siliconvalley4066/RaspberryPiPicoWTFTOscilloscope/README.md

# RaspberryPiPicoWTFTOscilloscope
Raspberry Pi Pico W Oscilloscope for 320x240 TFT LCD and wireless WEB display

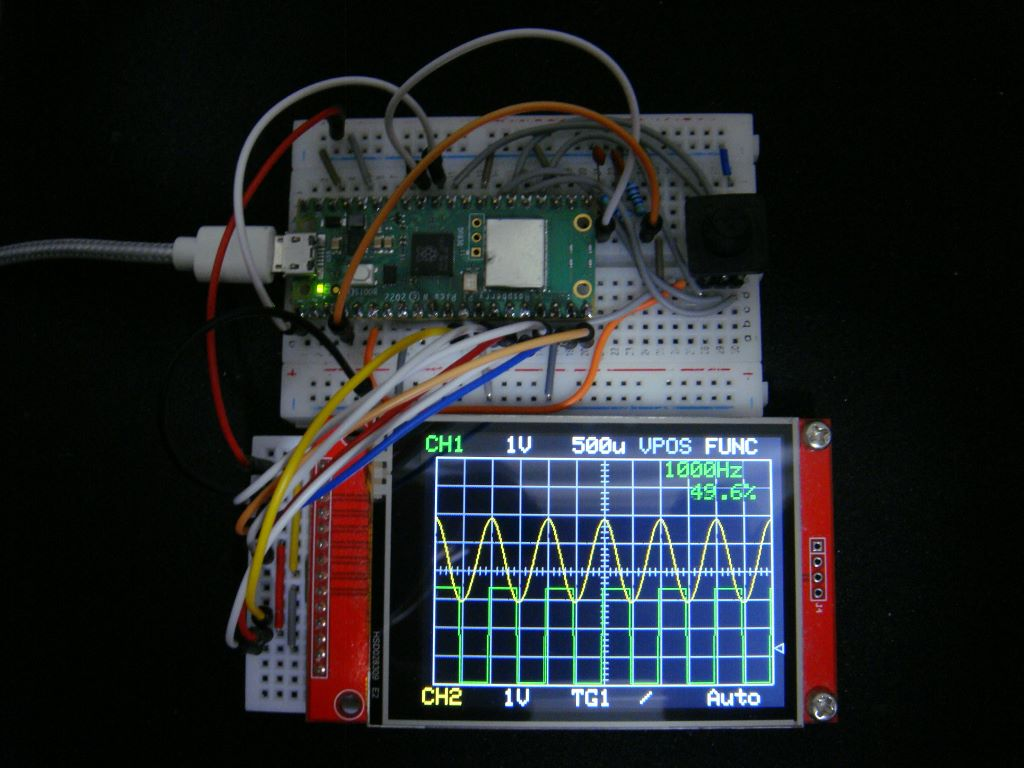
[picture p1: DSC03477.jpg]

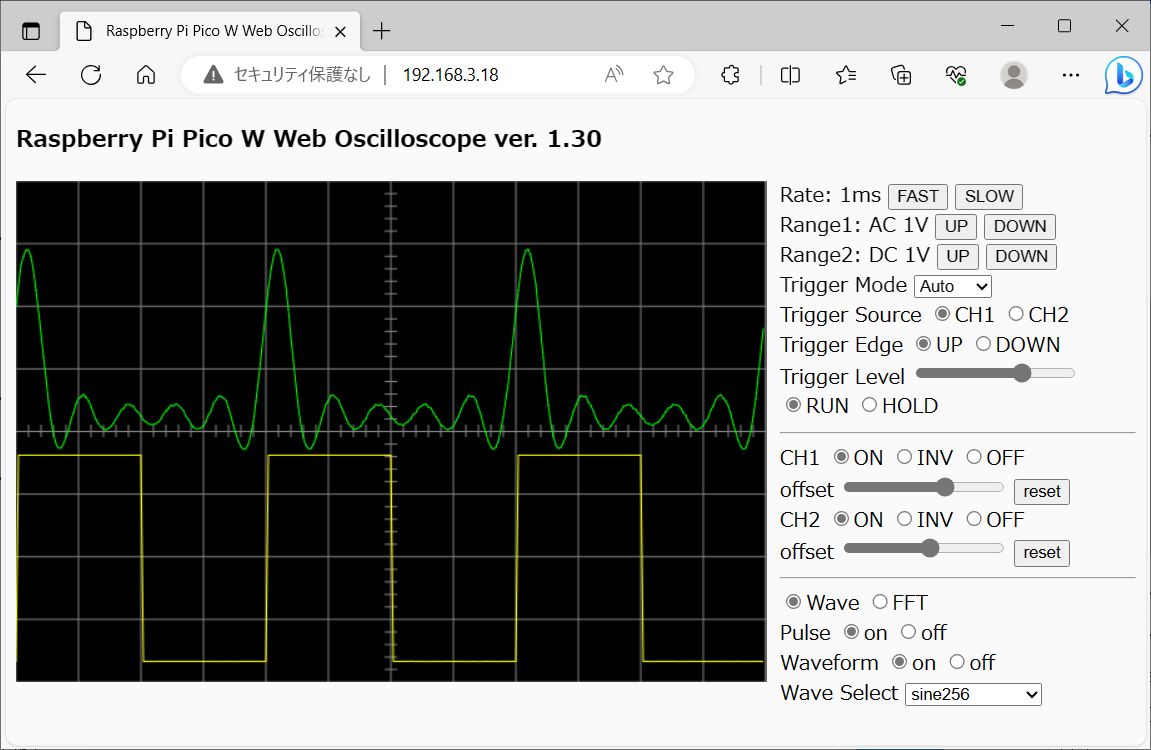
[picture p2: RPPicoWEBTFT.png]


This displays an oscilloscope screen on a 320x240 TFT LCD and also on the WEB page simultaneusly.
The settings are controled on the touch screen of the TFT LCD and by the 5 direction switch and also on the WEB page.
You can view the oscilloscope screen on the WEB browser of the PC or the tablet or the smartphone.
It contains Pulse Generator, DDS Function Generator and Frequency Counter.

Specifications:
<li>Dual input channel</li>
<li>Input voltage range 0 to 3.3V</li>
<li>12 bit ADC 2 Msps single channel, 250 ksps dual channel</li>
<li>Measures minimum, maximum and average values</li>
<li>Measures frequency and duty cycle</li>
<li>Spectrum FFT analysis</li>
<li>Sampling rate selection</li>
<li>Built in Pulse Generator</li>
<li>Built in DDS Function Generator</li>
<br>

The source codes can be compiled for Raspberry Pi Pico (not W) without WEB functions.

For WEB operations, edit the source code WebTask.ino and replace your Access Point and the password.
<pre>
Edit:
const char* ssid = "XXXX";
const char* pass = "YYYY";
To:
const char* ssid = "Your Access Point";
const char* pass = "Your Password";
</pre>

Develop environment is:<br>
Arduino IDE 2.3.10<br>
Raspberry Pi Pico/RP2040 by Earle F. Philhower, III version 6.3.0<br>
CPU speed 133MHz<br>

Libraries:<br>
TFT_eSPI 2.5.43<br>
arduinoFFT by Enrique Condes 2.0.0<br>
WebSockets by Markus Sattler version 2.7.2<br>

You need to customize the TFT_espi library by referring to the TFT_espi folder here.

For WEB only display, in case no LCD display is connected, un-comment
<pre>
//#define NOLCD
</pre>
in the file GOscillo.ino.

At 12.5 usec/div range (2 Msps), ADC is overclocked to 192MHz.<br>
At 25 usec/div range (1 Msps), ADC is overclocked to 96MHz.<br>
So, there may be some decrease in accuracy.<br>
The magnification applies sin(x)/x interpolation.

Schematics:<br>
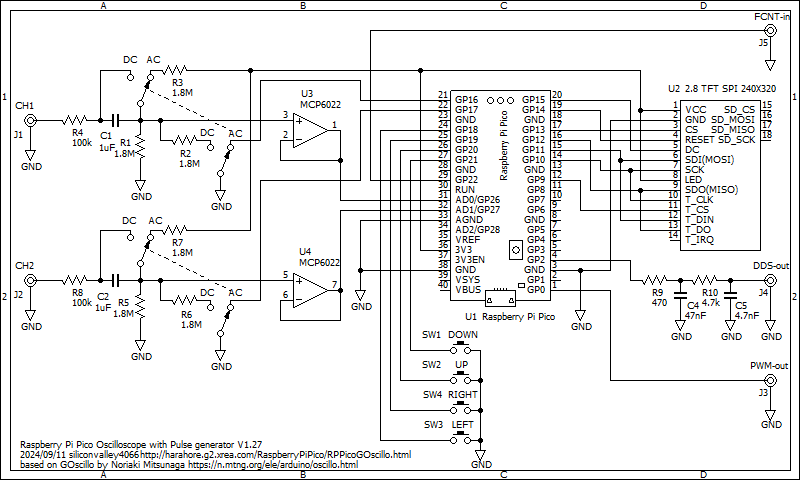
[picture p3: RPPicoTFTOscillo.png]
<br>
There is no software support for input attenuation yet.

Schematics for RP2040-Zero:<br>
Select the board "Waveshare RP2040 Zero" in the Arduino IDE<br>
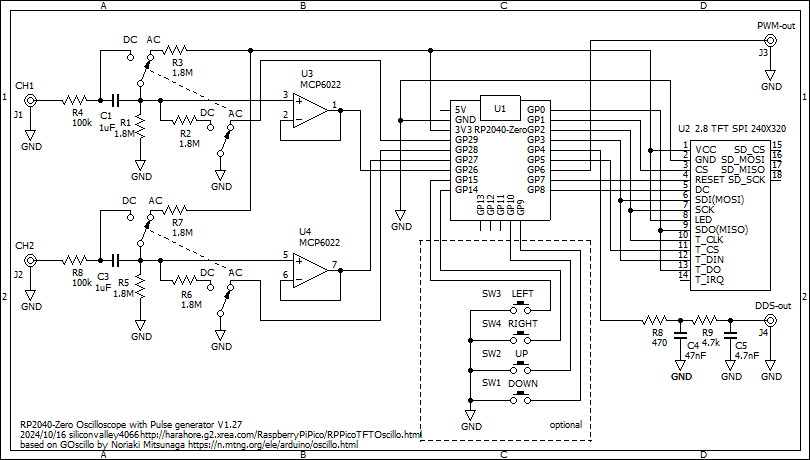
[picture p4: RP2040ZeroTFTOscillo.png]
<br>
There is no software support for input attenuation yet.

Description is here, although it is written in Japanese language:
https://ss1.xrea.com/harahore.g2.xrea.com/RaspberryPiPico/RPPicoTFTOscillo.html
