siliconvalley4066/RaspberryPiPicoWTFTOscilloscope/GOscillo/GOscillo.ino

/*
 * Raspberry Pi Pico W Oscilloscope using a 320x240 TFT and Web Version 1.30
 * The max realtime sampling rates are 250ksps with 2 channels and 2Msps with a channel.
 * + Pulse Generator
 * + PWM DDS Function Generator (23 waveforms)
 * + Frequency Counter (kHz)
 * Copyright (c) 2023,2026, Siliconvalley4066
 */
/*
 * Arduino Oscilloscope using a graphic LCD
 * The max sampling rates are 4.3ksps with 2 channels and 8.6ksps with a channel.
 * Copyright (c) 2009, Noriaki Mitsunaga
 */

// #define NOLCD
// #define NOWEB

#ifndef NOLCD
#include <SPI.h>
#include <TFT_eSPI.h>
TFT_eSPI display = TFT_eSPI();
#endif

#include "hardware/clocks.h"
#include "hardware/adc.h"
//#include "pico/multicore.h"

#define GPIN1 (22)

#if !defined(ARDUINO_RASPBERRY_PI_PICO_W)
#define NOWEB
#endif
#define BUTTON5DIR
#ifndef ARDUINO_ARCH_MBED_RP2040
#define EEPROM_START 0
#endif
#ifdef EEPROM_START
#include <EEPROM.h>
#endif
#include "arduinoFFT.h"
#define FFT_N 256
double vReal[FFT_N]; // Real part array, actually float type
double vImag[FFT_N]; // Imaginary part array
ArduinoFFT<double> FFT = ArduinoFFT<double>(vReal, vImag, FFT_N, 1.0);  // Create FFT object

#if defined(ARDUINO_WAVESHARE_RP2040_ZERO)
#include <Adafruit_NeoPixel.h>
#define DIN_PIN   16  // NeoPixel output pin is GP16
Adafruit_NeoPixel pixels(1, DIN_PIN, NEO_GRB + NEO_KHZ800);
#endif

float waveFreq[2];             // frequency (Hz)
float waveDuty[2];             // duty ratio (%)
int dataMin[2];                // buffer minimum value (smallest=0)
int dataMax[2];                //        maximum value (largest=4095)
int dataAve[2];                // 10 x average value (use 10x value to keep accuracy. so, max=40950)
int saveTimer;                 // remaining time for saving EEPROM
int timeExec;                  // approx. execution time of current range setting (ms)
extern byte duty;
extern byte p_range;
extern unsigned short count;
extern long ifreq;
extern byte wave_id;

const int LCD_WIDTH = 320;
const int LCD_HEIGHT = 240;
const int LCD_YMAX = 200;
const int SAMPLES = 300;
const int NSAMP = 2000;
const int DISPLNG = 300;
const int DOTS_DIV = 25;
const int XOFF = 10;
const int YOFF = 20;
const int TRIG_MAX = 199;
const byte ad_ch0 = 26;                 // Analog pin for channel 0
const byte ad_ch1 = 27;                 // Analog pin for channel 1
const long VREF[] = {83, 165, 413, 825, 1650}; // reference voltage 3.3V ->  82.5 :   1V/div range (40mV/dot)
                                        //                        -> 165 : 0.5V/div
                                        //                        -> 413 : 0.2V/div
                                        //                        -> 825 : 100mV/div
                                        //                        -> 1650 : 50mV/div
                                        // 3.3V / attn * DOTS_DIV / vdiv
//const int MILLIVOL_per_dot[] = {100, 50, 20, 10, 5}; // mV/dot
const int ac_offset[] PROGMEM = {2917, 434, -1055, -1552, -1800}; // 4 div offset
//                            = 4 * vdiv / 3.3 * 4096 - 2048
const int MODE_ON = 0;
const int MODE_INV = 1;
const int MODE_OFF = 2;
const char Modes[3][4] PROGMEM = {"ON", "INV", "OFF"};
const int TRIG_AUTO = 0;
const int TRIG_NORM = 1;
const int TRIG_SCAN = 2;
const int TRIG_ONE  = 3;
const char TRIG_Modes[4][5] PROGMEM = {"Auto", "Norm", "Scan", "One "};
const int TRIG_E_UP = 0;
const int TRIG_E_DN = 1;
#define RATE_MIN 0
#define RATE_MAX 18
#define RATE_DMA 4
#define RATE_DUAL 3
#define RATE_SLOW 10
#define RATE_ROLL 12
#define ITEM_MAX 29
const char Rates[19][5] PROGMEM = {"12.5", "25us", "50us", "100u", "200u", "500u", " 1ms", " 2ms", " 5ms", "10ms", "20ms", "50ms", "100m", "200m", "0.5s", " 1s ", " 2s ", " 5s ", " 10s"};
const unsigned long HREF[] PROGMEM = {5, 10, 20, 40, 80, 200, 400, 800, 2000, 4000, 8000, 20000, 40000, 80000, 200000, 400000, 800000, 2000000, 4000000, 8000000};
#define RANGE_MIN 0
#define RANGE_MAX 4
#define VRF 3.3
const char Ranges[5][5] PROGMEM = {" 1V ", "0.5V", "0.2V", "0.1V", "50mV"};
byte range0 = RANGE_MIN;
byte range1 = RANGE_MIN;
byte ch0_mode = MODE_ON, ch1_mode = MODE_ON, rate = 0, orate, wrate = 0;
byte trig_mode = TRIG_AUTO, trig_lv = 10, trig_edge = TRIG_E_UP, trig_ch = ad_ch0;
bool Start = true;  // Start sampling
byte item = 0;      // Default item
short ch0_off = 0, ch1_off = 400;
byte data[4][SAMPLES];                  // keep twice of the number of channels to make it a double buffer
uint16_t cap_buf[NSAMP], cap_buf1[NSAMP];
#ifndef NOWEB
uint16_t payload[SAMPLES*2+2];
#endif
byte odat00, odat01, odat10, odat11;    // old data buffer for erase
byte sample=0;                          // index for double buffer
bool fft_mode = false, pulse_mode = false, dds_mode = false, fcount_mode = false;
byte info_mode = 3; // Text information display mode
int trigger_ad;
float sys_clk;      // System clock is typically 125MHz, eventually 133MHz
volatile bool wfft, wdds;
byte time_mag = 1;  // magnify timebase: 1, 2, 5 or 10
int trigger_pos;
int mag_pos = 0;

#if defined(ARDUINO_WAVESHARE_RP2040_ZERO)
#define LEFTPIN   15  // LEFT
#define RIGHTPIN  14  // RIGHT
#define UPPIN     10  // UP
#define DOWNPIN    9  // DOWN
#define CH0DCSW   29  // DC/AC switch ch0
#define CH1DCSW   28  // DC/AC switch ch1
#else
#define LEFTPIN   18  // LEFT
#define RIGHTPIN  19  // RIGHT
#define UPPIN     20  // UP
#define DOWNPIN   21  // DOWN
#define CH0DCSW   16  // DC/AC switch ch0
#define CH1DCSW   17  // DC/AC switch ch1
#endif

#define BGCOLOR   TFT_BLACK
#define GRIDCOLOR TFT_DARKGREY
#define CH1COLOR  TFT_GREEN
#define CH2COLOR  TFT_YELLOW
#define FRMCOLOR  TFT_LIGHTGREY
#define TXTCOLOR  TFT_WHITE
#define HIGHCOLOR TFT_CYAN
#define OFFCOLOR  TFT_DARKGREY
#define REDCOLOR  TFT_RED
#define MAGCOLOR  TFT_BLUE
#define LED_ON    HIGH
#define LED_OFF   LOW
#define INFO_OFF  0x20
#define INFO_BIG  0x10
#define INFO_VOL2 0x08
#define INFO_VOL1 0x04
#define INFO_FRQ2 0x02
#define INFO_FRQ1 0x01

void setup(){
  pinMode(CH0DCSW, INPUT_PULLUP);   // CH1 DC/AC
  pinMode(CH1DCSW, INPUT_PULLUP);   // CH2 DC/AC
  pinMode(UPPIN, INPUT_PULLUP);     // up
  pinMode(DOWNPIN, INPUT_PULLUP);   // down
  pinMode(RIGHTPIN, INPUT_PULLUP);  // right
  pinMode(LEFTPIN, INPUT_PULLUP);   // left
  // setPERIClock48MHz();
#if defined(ARDUINO_WAVESHARE_RP2040_ZERO)
  pixels.begin();                   // NeoPixel start
#else
  pinMode(LED_BUILTIN, OUTPUT);     // sets the digital pin as output
#endif
#ifndef NOLCD
  display.init();                    // initialise the library
  display.setRotation(3);
  uint16_t calData[5] = { 323, 3532, 343, 3449, 1 };  // rotation 3
//  uint16_t calData[5] = { 358, 3534, 310, 3481, 7 };  // rotation 1
  display.setTouch(calData);
  display.fillScreen(BGCOLOR);
#endif

//  Serial.begin(115200);
//  delay(3000);
//  Serial.println("core0:start....");
//  multicore_launch_core1(loop1);
#ifdef EEPROM_START
  EEPROM.begin(512);                    // set EEPROM size. Necessary for Raspberry Pi Pico
  loadEEPROM();                         // read last settings from EEPROM
#else
  set_default();
#endif
  wfft = fft_mode;
  wdds = dds_mode;
//  DrawGrid();
//  DrawText();
//  display.display();
  sys_clk = (float) clock_get_hz(clk_sys);  // identify 125MHz or 133MHz or else
  if (pulse_mode)
    pulse_init();                       // calibration pulse output
  if (dds_mode)
    dds_setup();
  orate = RATE_DMA + 1;                 // old rate befor change
  dmaadc_setup(0);                      // initial setup for DMA adc
  clock_configure_gpin(clk_gpout0, GPIN1, 1000, 1000);  // frequency count on GPIO22
}

#ifndef NOLCD
#ifdef DOT_GRID
void DrawGrid() {
  int disp_leng;
  disp_leng = DISPLNG;
  for (int x=0; x<=disp_leng; x += 5) { // Horizontal Line
    for (int y=0; y<=LCD_YMAX; y += DOTS_DIV) {
      display.drawPixel(XOFF+x, YOFF+y, GRIDCOLOR);
//      CheckSW();
    }
  }
  for (int x=0; x<=disp_leng; x += DOTS_DIV ) { // Vertical Line
    for (int y=0; y<=LCD_YMAX; y += 5) {
      display.drawPixel(XOFF+x, YOFF+y, GRIDCOLOR);
//      CheckSW();
    }
  }
}
#else
void DrawGrid() {
  display.drawFastVLine(XOFF, YOFF, LCD_YMAX, FRMCOLOR);          // left vertical line
  display.drawFastVLine(XOFF+SAMPLES, YOFF, LCD_YMAX, FRMCOLOR);  // right vertical line
  display.drawFastHLine(XOFF, YOFF, SAMPLES, FRMCOLOR);           // top horizontal line
  display.drawFastHLine(XOFF, YOFF+LCD_YMAX, SAMPLES, FRMCOLOR);  // bottom horizontal line

  for (int y = 0; y < LCD_YMAX; y += DOTS_DIV) {
    if (y > 0){
      display.drawFastHLine(XOFF+1, YOFF+y, SAMPLES - 1, GRIDCOLOR);  // Draw 9 horizontal lines
    }
    for (int i = 5; i < DOTS_DIV; i += 5) {
      display.drawFastHLine(XOFF+SAMPLES / 2 - 3, YOFF+y + i, 7, GRIDCOLOR);  // Draw the vertical center line ticks
    }
  }
  for (int x = 0; x < SAMPLES; x += DOTS_DIV) {
    if (x > 0){
      display.drawFastVLine(XOFF+x, YOFF+1, LCD_YMAX - 1, GRIDCOLOR); // Draw 11 vertical lines
    }
    for (int i = 5; i < DOTS_DIV; i += 5) {
      display.drawFastVLine(XOFF+x + i, YOFF+LCD_YMAX / 2 -3, 7, GRIDCOLOR);  // Draw the horizontal center line ticks
    }
  }
}
#endif

unsigned long fcount = 0;
//const double freq_ratio = 20000.0 / 19987.0;

void fcount_disp() {
  char s[10];
  if (!fcount_mode) return;
  fcount = frequency_count_khz(CLOCKS_FC0_SRC_VALUE_CLKSRC_GPIN1);
//  fcount = frequency_count_khz(CLOCKS_FC0_SRC_VALUE_PLL_SYS_CLKSRC_PRIMARY);
//  fcount = fcount * freq_ratio; // compensate the ceramic osc
  sprintf(s, "%6lukHz", fcount);
  display.print(s);
}

void display_range(byte rng) {
  display.print(Ranges[rng]);
}

void display_rate(void) {
  display.print(Rates[rate]);
}

void display_mode(byte chmode) {
  display.print(Modes[chmode]); 
}

void display_trig_mode(void) {
  display.print(TRIG_Modes[trig_mode]); 
}

void display_ac(byte pin) {
  if (digitalRead(pin) == LOW) display.print('~');
}

void DrawGrid(int x) {
  if ((x % DOTS_DIV) == 0) {
    for (int y=0; y<=LCD_YMAX; y += 5)
      display.drawPixel(XOFF+x, YOFF+y, GRIDCOLOR);
  } else if ((x % 5) == 0)
    for (int y=0; y<=LCD_YMAX; y += DOTS_DIV)
      display.drawPixel(XOFF+x, YOFF+y, GRIDCOLOR);
}

void ClearAndDrawGraph() {
  int clear;
  byte *p1, *p2, *p3, *p4, *p5, *p6, *p7, *p8;
  int disp_leng;
  disp_leng = DISPLNG-1;
  bool ch1_active = ch1_mode != MODE_OFF && !(rate < RATE_DUAL && ch0_mode != MODE_OFF);
  if (sample == 0)
    clear = 2;
  else
    clear = 0;
  p1 = data[clear+0];
  p2 = p1 + 1;
  p3 = data[sample+0];
  p4 = p3 + 1;
  p5 = data[clear+1];
  p6 = p5 + 1;
  p7 = data[sample+1];
  p8 = p7 + 1;
#if 0
  for (int x=0; x<disp_leng; x++) {
    display.drawPixel(XOFF+x, YOFF+LCD_YMAX-data[sample+0][x], CH1COLOR);
    display.drawPixel(XOFF+x, YOFF+LCD_YMAX-data[sample+1][x], CH2COLOR);
  }
#else
  for (int x=0; x<disp_leng; x++) {
    if (ch0_mode != MODE_OFF) {
      display.drawLine(XOFF+x, YOFF+LCD_YMAX-*p1++, XOFF+x+1, YOFF+LCD_YMAX-*p2++, BGCOLOR);
      display.drawLine(XOFF+x, YOFF+LCD_YMAX-*p3++, XOFF+x+1, YOFF+LCD_YMAX-*p4++, CH1COLOR);
    }
    if (ch1_active) {
      display.drawLine(XOFF+x, YOFF+LCD_YMAX-*p5++, XOFF+x+1, YOFF+LCD_YMAX-*p6++, BGCOLOR);
      display.drawLine(XOFF+x, YOFF+LCD_YMAX-*p7++, XOFF+x+1, YOFF+LCD_YMAX-*p8++, CH2COLOR);
    }
  }
#endif
}

void ClearAndDrawDot(int i) {
  DrawGrid(i);
#if 0
  for (int x=0; x<DISPLNG; x++) {
    display.drawPixel(XOFF+i, YOFF+LCD_YMAX-odat01, BGCOLOR);
    display.drawPixel(XOFF+i, YOFF+LCD_YMAX-odat11, BGCOLOR);
    display.drawPixel(XOFF+i, YOFF+LCD_YMAX-data[sample+0][i], CH1COLOR);
    display.drawPixel(XOFF+i, YOFF+LCD_YMAX-data[sample+1][i], CH2COLOR);
  }
#else
  if (i < 1) {
    return;
  }
  if (ch0_mode != MODE_OFF) {
    display.drawLine(XOFF+i-1, YOFF+LCD_YMAX-odat00,   XOFF+i, YOFF+LCD_YMAX-odat01, BGCOLOR);
    display.drawLine(XOFF+i-1, YOFF+LCD_YMAX-data[0][i-1], XOFF+i, YOFF+LCD_YMAX-data[0][i], CH1COLOR);
  }
  if (ch1_mode != MODE_OFF) {
    display.drawLine(XOFF+i-1, YOFF+LCD_YMAX-odat10,   XOFF+i, YOFF+LCD_YMAX-odat11, BGCOLOR);
    display.drawLine(XOFF+i-1, YOFF+LCD_YMAX-data[1][i-1], XOFF+i, YOFF+LCD_YMAX-data[1][i], CH2COLOR);
  }
#endif
}
#endif

void scaleDataArray(byte ad_ch, int trig_point)
{
  byte *pdata, ch_mode, range, ch;
  short ch_off;
  uint16_t *idata, *qdata, *rdata;
  long a, b;

  trigger_pos = trig_point;
  if (ad_ch == ad_ch1) {
    ch_off = ch1_off;
    ch_mode = ch1_mode;
    range = range1;
    idata = &cap_buf1[trig_point];
#ifndef NOWEB
    qdata = rdata = payload+SAMPLES;
#endif
    ch = 1;
  } else {
    ch_off = ch0_off;
    ch_mode = ch0_mode;
    range = range0;
    idata = &cap_buf[trig_point];
#ifndef NOWEB
    qdata = rdata = payload;
#endif
    ch = 0;
  }
  pdata = data[sample+ch];
  for (int i = 0; i < SAMPLES; i++) {
    a = ((*idata + ch_off) * VREF[range] + 2048) >> 12;
    if (a > LCD_YMAX) a = LCD_YMAX;
    else if (a < 0) a = 0;
    if (ch_mode == MODE_INV)
      a = LCD_YMAX - a;
    *pdata++ = (byte) a;
#ifndef NOWEB
    b = ((*idata++ + ch_off) * VREF[range] + 101) / 201;
    if (b > 4095) b = 4095;
    else if (b < 0) b = 0;
    if (ch_mode == MODE_INV)
      b = 4095 - b;
    *qdata++ = (int16_t) b;
#else
    ++idata;
#endif
  }
  if (rate < RATE_ROLL) {
    switch (time_mag) {
    case 2:
    case 5:
    case 10:
      // Empirical: ensures mag() does not read beyond buffer end for factors 2/5/10
      mag_pos = constrain(mag_pos, 0, SAMPLES - SAMPLES/time_mag - 6);
      mag(data[sample+ch], time_mag, mag_pos);  // magnify timebase for display
#ifndef NOWEB
      mag(rdata, time_mag, mag_pos);            // magnify timebase for WEB
#endif
      break;
    default:
      time_mag = 1;   // fix odd value
      mag_pos = 0;    // reset the position
      break;
    }
  }
}

byte adRead(byte ch, byte mode, int off, int i)
{
  if (ch == ad_ch1) {
    adc_select_input(1);
  } else {
    adc_select_input(0);
  }
  int16_t aa = adc_read();
  long a = (((long)aa+off)*VREF[ch == ad_ch0 ? range0 : range1]+2048) >> 12;
  if (a > LCD_YMAX) a = LCD_YMAX;
  else if (a < 0) a = 0;
  if (mode == MODE_INV)
    a = LCD_YMAX - a;
#ifndef NOWEB
  long b = (((long)aa+off)*VREF[ch == ad_ch0 ? range0 : range1] + 101) / 201;
  if (b > 4095) b = 4095;
  else if (b < 0) b = 0;
  if (mode == MODE_INV)
    b = 4095 - b;
#endif
  if (ch == ad_ch1) {
    cap_buf1[i] = aa;
#ifndef NOWEB
    payload[i+SAMPLES] = b;
#endif
  } else {
    cap_buf[i] = aa;
#ifndef NOWEB
    payload[i] = b;
#endif
  }
  return a;
}

int advalue(int value, long vref, byte mode, int offs) {
  if (mode == MODE_INV)
    value = LCD_YMAX - value;
  return ((long)value << 12) / vref - offs;
}

void set_trigger_ad() {
  if (trig_ch == ad_ch0) {
    trigger_ad = advalue(trig_lv, VREF[range0], ch0_mode, ch0_off);
    adc_select_input(0);
  } else {
    trigger_ad = advalue(trig_lv, VREF[range1], ch1_mode, ch1_off);
    adc_select_input(1);
  }
}

void loop() {
  int oad, ad;
  unsigned long auto_time;

  timeExec = 100;
  led_on();
  if (rate > RATE_DMA) {
    adc_set_round_robin(0); // de-activate round robin
    set_trigger_ad();
    auto_time = pow(10, rate / 3) + 5;
    if (trig_mode != TRIG_SCAN) {
      unsigned long st = millis();
      oad = adc_read();
      for (;;) {
        ad = adc_read();

        if (trig_edge == TRIG_E_UP) {
          if (ad > trigger_ad && trigger_ad > oad)
            break;
        } else {
          if (ad < trigger_ad && trigger_ad < oad)
            break;
        }
        oad = ad;

        if (rate > RATE_SLOW)
          CheckSW();      // no need for fast sampling
        if (trig_mode == TRIG_SCAN)
          break;
        if (trig_mode == TRIG_AUTO && (millis() - st) > auto_time)
          break; 
      }
    }
  }

  // sample and draw depending on the sampling rate
  if (rate < RATE_ROLL && Start) {
    // change the index for the double buffer
    if (sample == 0)
      sample = 2;
    else
      sample = 0;

    if (rate <= 2) {        // DMA, channel 0 only 2us sampling (500ksps)
      sample_2us();
    } else if (rate <= RATE_DMA) {  // DMA, dual channel 4us,8us sampling (250ksps,125ksps)
      sample_4us();
    } else if (rate > RATE_DMA && rate <= 8) {  // dual channel 20us, 40us, 80us, 200us sampling
      sample_dual_us(HREF[rate] / 10);
    } else {                // dual channel 0.4ms, 0.8ms, 2ms sampling
      sample_dual_ms(HREF[rate] / 10);
    }
    led_off();
    draw_screen();
  } else if (Start) { // 4ms - 400ms sampling
    timeExec = 5000;
    static const unsigned long r_[] PROGMEM = {4000, 8000, 20000, 40000, 80000, 200000, 400000};
    unsigned long r;
    int disp_leng;
    disp_leng = DISPLNG;
//    unsigned long st0 = millis();
    unsigned long st = micros();
    for (int i=0; i<disp_leng; i ++) {
      r = r_[rate - RATE_ROLL];  // rate may be changed in loop
      while((st - micros())<r) {
        CheckSW();
        if (rate < RATE_ROLL)
          break;
      }
      if (rate<RATE_ROLL) { // sampling rate has been changed
#ifndef NOLCD
        display.fillScreen(BGCOLOR);
#endif
        break;
      }
      st += r;
      if (st - micros()>r)
          st = micros(); // sampling rate has been changed to shorter interval
      if (!Start) {
         i --;
         continue;
      }
      odat00 = odat01;      // save next previous data ch0
      odat10 = odat11;      // save next previous data ch1
      odat01 = data[0][i];  // save previous data ch0
      odat11 = data[1][i];  // save previous data ch1
      if (ch0_mode != MODE_OFF) data[0][i] = adRead(ad_ch0, ch0_mode, ch0_off, i);
      if (ch1_mode != MODE_OFF) data[1][i] = adRead(ad_ch1, ch1_mode, ch1_off, i);
#ifndef NOWEB
      if (ch0_mode == MODE_OFF) payload[0] = -1;
      if (ch1_mode == MODE_OFF) payload[SAMPLES] = -1;
      rp2040.fifo.push_nb(1);   // notify Websocket server core
#endif
#ifndef NOLCD
      ClearAndDrawDot(i);
#endif
    }
#ifndef NOLCD
    DrawGrid(disp_leng);  // right side grid   
#endif
    // Serial.println(millis()-st0);
    led_off();
//    DrawGrid();
    DrawText();
  } else {
    DrawText();
  }
  if (trig_mode == TRIG_ONE)
    Start = false;
  CheckSW();
#ifdef EEPROM_START
  saveEEPROM();                         // save settings to EEPROM if necessary
#endif
  if (wdds != dds_mode) {
    if (wdds) {
      dds_setup();
    } else {
      dds_close();
    }
    dds_mode = wdds;
  }
}

void draw_screen() {
  if (wfft != fft_mode) {
    fft_mode = wfft;
#ifndef NOLCD
    display.fillScreen(BGCOLOR);
#endif
  }
  if (fft_mode) {
    DrawText();
    plotFFT();
  } else {
#ifndef NOLCD
    DrawGrid();
    ClearAndDrawGraph();
    mag_bar();
#endif
    DrawText();
#ifndef NOWEB
    if (ch0_mode == MODE_OFF) payload[0] = -1;
    if (ch1_mode == MODE_OFF) payload[SAMPLES] = -1;
#endif
  }
#ifndef NOWEB
  rp2040.fifo.push_nb(1);   // notify Websocket server core
  delay(10);    // wait Web task to send it (adhoc fix)
#endif
}

#define textINFO 214
void measure_frequency(int ch) {
  int x1, x2;
  byte y;
  freqDuty(ch);
#ifndef NOLCD
  if (info_mode & INFO_BIG) {
    x1 = textINFO, x2 = x1+24;        // Big
  } else {
    x1 = textINFO + 48, x2 = x1+12;   // Small
  }
  if (ch == 0) {
    y = 22;
    display.setTextColor(CH1COLOR, BGCOLOR);
  } else {
    y = 122;
    display.setTextColor(CH2COLOR, BGCOLOR);
  }
  TextBG(&y, x1, 8);
  float freq = waveFreq[ch];
  if (freq < 999.5)
    display.print(freq);
  else if (freq < 999999.5)
    display.print(freq, 0);
  else {
    display.print(freq/1000.0, 0);
    display.print('k');
  }
  display.print("Hz");
  if (fft_mode) return;
  TextBG(&y, x2, 6);
  float duty = waveDuty[ch];
  if (duty > 99.9499) duty = 99.9;
  display.print(duty, 1);  display.print('%');
#endif
}

void measure_voltage(int ch) {
  int x;
  byte y;
  if (fft_mode) return;
  float vavr = VRF * dataAve[ch] / 40950.0;
  float vmax = VRF * dataMax[ch] / 4095.0;
  float vmin = VRF * dataMin[ch] / 4095.0;
#ifndef NOLCD
  if (info_mode & INFO_BIG) {
    x = textINFO, y = 62;       // Big
  } else {
    x = textINFO + 48, y = 42;  // Small
  }
  if (ch == 0) {
    display.setTextColor(CH1COLOR, BGCOLOR);
  } else {
    y += 100;
    display.setTextColor(CH2COLOR, BGCOLOR);
  }
  TextBG(&y, x, 8);
  display.print("max");  display.print(vmax); if (vmax >= 0.0) display.print('V');
  TextBG(&y, x, 8);
  display.print("avr");  display.print(vavr); if (vavr >= 0.0) display.print('V');
  TextBG(&y, x, 8);
  display.print("min");  display.print(vmin); if (vmin >= 0.0) display.print('V');
#endif
}

void sample_dual_us(unsigned int r) { // dual channel. r > 67
  if (ch0_mode != MODE_OFF && ch1_mode == MODE_OFF) {
    adc_select_input(0);
    unsigned long st = micros();
    for (int i=0; i<SAMPLES; i ++) {
      while(micros() - st < r) ;
      cap_buf[i] = adc_read();
      st += r;
    }
    scaleDataArray(ad_ch0, 0);
  } else if (ch0_mode == MODE_OFF && ch1_mode != MODE_OFF) {
    adc_select_input(1);
    unsigned long st = micros();
    for (int i=0; i<SAMPLES; i ++) {
      while(micros() - st < r) ;
      cap_buf1[i] = adc_read();
      st += r;
    }
    scaleDataArray(ad_ch1, 0);
  } else {
    unsigned long st = micros();
    for (int i=0; i<SAMPLES; i ++) {
      while(micros() - st < r) ;
      adc_select_input(0);
      cap_buf[i] = adc_read();
      adc_select_input(1);
      cap_buf1[i] = adc_read();
      st += r;
    }
    scaleDataArray(ad_ch0, 0);
    scaleDataArray(ad_ch1, 0);
  }
}

void sample_dual_ms(unsigned int r) { // dual channel. r > 500
// .5ms, 1ms or 2ms sampling
  unsigned long st = micros();
  for (int i=0; i<SAMPLES; i ++) {
    while(micros() - st < r) ;
    st += r;
    if (ch0_mode != MODE_OFF) {
      adc_select_input(0);
      cap_buf[i] = adc_read();
    }
    if (ch1_mode != MODE_OFF) {
      adc_select_input(1);
      cap_buf1[i] = adc_read();
    }
  }
//  if (ch0_mode == MODE_OFF) memset(data[0], 0, SAMPLES);
//  if (ch1_mode == MODE_OFF) memset(data[1], 0, SAMPLES);
  scaleDataArray(ad_ch0, 0);
  scaleDataArray(ad_ch1, 0);
}

void plotFFT() {
  byte *lastplot, *newplot;
  int ylim = 200;

  int clear = (sample == 0) ? 2 : 0;
  int j = 0;
  if (rate <= RATE_DMA) {
    j = trigger_pos;
  }
  for (int i = 0; i < FFT_N; i++) {
    vReal[i] = cap_buf[j++];
    vImag[i] = 0.0;
  }
  FFT.dcRemoval();
  FFT.windowing(FFTWindow::Hann, FFTDirection::Forward);  // Weigh data
  FFT.compute(FFTDirection::Forward);                     // Compute FFT
  FFT.complexToMagnitude();                               // Compute magnitudes
  newplot = data[sample];
  lastplot = data[clear];
#ifndef NOWEB
  payload[0] = 0;
#endif
  for (int i = 1; i < FFT_N/2; i++) {
    float db = log10(vReal[i]);
#ifndef NOWEB
    payload[i] = constrain((int)(1024.0 * (db - 1.6)), 0, 4095);
#endif
#ifndef NOLCD
    int dat = constrain((int)(50.0 * (db - 1.6)), 0, ylim);
    display.drawFastVLine(i * 2, ylim - lastplot[i], lastplot[i], BGCOLOR); // erase old
    display.drawFastVLine(i * 2, ylim - dat, dat, CH1COLOR);
    newplot[i] = dat;
#endif
  }
  draw_scale();
}

void draw_scale() {
  int ylim = 204;
  float fhref, nyquist;
#ifndef NOLCD
  display.setTextColor(TXTCOLOR);
  display.setCursor(0, ylim); display.print("0Hz"); 
#endif
  fhref = freqhref();
  nyquist = 5.0e6 / fhref; // Nyquist frequency
#ifndef NOWEB
  long inyquist = nyquist;
  payload[FFT_N/2] = (short) (inyquist / 1000);
  payload[FFT_N/2+1] = (short) (inyquist % 1000);
#endif
#ifndef NOLCD
  if (nyquist > 999.0) {
    nyquist = nyquist / 1000.0;
    if (nyquist > 99.5) {
      display.setCursor(116, ylim); display.print(nyquist/2,0);display.print('k');
      display.setCursor(232, ylim); display.print(nyquist,0);
    } else if (nyquist > 9.95) {
      display.setCursor(122, ylim); display.print(nyquist/2,0);display.print('k');
      display.setCursor(238, ylim); display.print(nyquist,0);
    } else {
      display.setCursor(122, ylim); display.print(nyquist/2,1);display.print('k');
      display.setCursor(232, ylim); display.print(nyquist,1);
    }
    display.print('k');
  } else {
    display.setCursor(116, ylim); display.print(nyquist/2,0);
    display.setCursor(238, ylim); display.print(nyquist,0);
  }
#endif
}

float freqhref() {
  return (float) HREF[rate];
}

#if defined(ARDUINO_WAVESHARE_RP2040_ZERO)
void led_on(void) {
  pixels.setPixelColor(0, pixels.Color(0, 16, 0)); pixels.show(); // green
}

void led_off(void) {
  pixels.setPixelColor(0, pixels.Color(0, 0, 0)); pixels.show();  // off
}
#else
void led_on(void) {
  digitalWrite(LED_BUILTIN, LED_ON);
}

void led_off(void) {
  digitalWrite(LED_BUILTIN, LED_OFF);
}
#endif

#ifdef EEPROM_START
void saveEEPROM() {                   // Save the setting value in EEPROM after waiting a while after the button operation.
  uint16_t p = EEPROM_START;
  if (saveTimer > 0) {                // If the timer value is positive
    saveTimer = saveTimer - timeExec; // Timer subtraction
    if (saveTimer <= 0) {             // if time up
      EEPROM.write(p++, range0);      // save current status to EEPROM
      EEPROM.write(p++, ch0_mode);
      EEPROM.write(p++, lowByte(ch0_off));  // save as Little endian
      EEPROM.write(p++, highByte(ch0_off));
      EEPROM.write(p++, range1);
      EEPROM.write(p++, ch1_mode);
      EEPROM.write(p++, lowByte(ch1_off));  // save as Little endian
      EEPROM.write(p++, highByte(ch1_off));
      EEPROM.write(p++, rate);
      EEPROM.write(p++, trig_mode);
      EEPROM.write(p++, trig_lv);
      EEPROM.write(p++, trig_edge);
      EEPROM.write(p++, trig_ch);
      EEPROM.write(p++, fft_mode);
      EEPROM.write(p++, info_mode);
      EEPROM.write(p++, item);
      EEPROM.write(p++, pulse_mode);
      EEPROM.write(p++, duty);
      EEPROM.write(p++, p_range);
      EEPROM.write(p++, lowByte(count));  // save as Little endian
      EEPROM.write(p++, highByte(count));
      EEPROM.write(p++, dds_mode);
      EEPROM.write(p++, wave_id);
      EEPROM.write(p++, ifreq & 0xff);
      EEPROM.write(p++, (ifreq >> 8) & 0xff);
      EEPROM.write(p++, (ifreq >> 16) & 0xff);
      EEPROM.write(p++, (ifreq >> 24) & 0xff);
      EEPROM.write(p++, time_mag);
      EEPROM.commit();    // actually write EEPROM. Necessary for Raspberry Pi Pico
    }
  }
}
#endif

void set_default() {
  range0 = RANGE_MIN;
  ch0_mode = MODE_ON;
  ch0_off = 0;
  range1 = RANGE_MIN;
  ch1_mode = MODE_ON;
  ch1_off = 2048;
  rate = 6;
  trig_mode = TRIG_AUTO;
  trig_lv = 20;
  trig_edge = TRIG_E_UP;
  trig_ch = ad_ch0;
  fft_mode = false;
  info_mode = 1;  // display frequency and duty.  Voltage display is off
  item = 0;       // menu item
  pulse_mode = true;
  duty = 128;     // PWM 50%
  p_range = 0;    // PWM range
  count = 12499;  // PWM 10kHz
  dds_mode = true;
  wave_id = 0;    // sine wave
  ifreq = 23841;  // 238.41Hz
  time_mag = 1;   // magnify timebase
}

extern const byte wave_num;

#ifdef EEPROM_START
void loadEEPROM() { // Read setting values from EEPROM (abnormal values will be corrected to default)
  uint16_t p = EEPROM_START, error = 0;

  range0 = EEPROM.read(p++);                // range0
  if ((range0 < RANGE_MIN) || (range0 > RANGE_MAX)) ++error;
  ch0_mode = EEPROM.read(p++);              // ch0_mode
  if (ch0_mode > 2) ++error;
  *((byte *)&ch0_off) = EEPROM.read(p++);     // ch0_off low
  *((byte *)&ch0_off + 1) = EEPROM.read(p++); // ch0_off high
  if ((ch0_off < -8192) || (ch0_off > 8191)) ++error;

  range1 = EEPROM.read(p++);                // range1
  if ((range1 < RANGE_MIN) || (range1 > RANGE_MAX)) ++error;
  ch1_mode = EEPROM.read(p++);              // ch1_mode
  if (ch1_mode > 2) ++error;
  *((byte *)&ch1_off) = EEPROM.read(p++);     // ch1_off low
  *((byte *)&ch1_off + 1) = EEPROM.read(p++); // ch1_off high
  if ((ch1_off < -8192) || (ch1_off > 8191)) ++error;

  rate = EEPROM.read(p++);                  // rate
  if ((rate < RATE_MIN) || (rate > RATE_MAX)) ++error;
//  if (ch0_mode == MODE_OFF && rate < 5) ++error;  // correct ch0_mode
  trig_mode = EEPROM.read(p++);             // trig_mode
  if (trig_mode > TRIG_SCAN) ++error;
  trig_lv = EEPROM.read(p++);               // trig_lv
  if (trig_lv > TRIG_MAX) ++error;
  trig_edge = EEPROM.read(p++);             // trig_edge
  if (trig_edge > 1) ++error;
  trig_ch = EEPROM.read(p++);               // trig_ch
  if (trig_ch != ad_ch0 && trig_ch != ad_ch1) ++error;
  fft_mode = EEPROM.read(p++);              // fft_mode
  info_mode = EEPROM.read(p++);             // info_mode
  if (info_mode > 63) ++error;
  item = EEPROM.read(p++);                  // item
  if (item > ITEM_MAX) ++error;
  pulse_mode = EEPROM.read(p++);            // pulse_mode
  duty = EEPROM.read(p++);                  // duty
  p_range = EEPROM.read(p++);               // p_range
  if (p_range > 8) ++error;
  *((byte *)&count) = EEPROM.read(p++);     // count low
  *((byte *)&count + 1) = EEPROM.read(p++); // count high
  dds_mode = EEPROM.read(p++);              // DDS mode
  wave_id = EEPROM.read(p++);               // DDS wave id
  if (wave_id >= wave_num) ++error;
  *((byte *)&ifreq) = EEPROM.read(p++);     // ifreq low
  *((byte *)&ifreq + 1) = EEPROM.read(p++); // ifreq
  *((byte *)&ifreq + 2) = EEPROM.read(p++); // ifreq
  *((byte *)&ifreq + 3) = EEPROM.read(p++); // ifreq high
  if (ifreq > 999999L) ++error;
  time_mag = EEPROM.read(p++);              // magnify timebase
  if (error > 0) {
    set_default();
  }
}
#endif
