siliconvalley4066/RaspberryPiPicoWTFTOscilloscope/(commit log)

2023-09-08 activate WiFi only for Pico W
2023-09-13 replace ESP32 identification
2023-10-10 fix switch operation at FCNT
    Fix displays changed by tactile switches arround FCNT
    [gui.ino]
2023-11-01 update the schematics
2024-03-09 arduinoFFT 2.0.0
2024-09-01 schematics V1.09
2024-09-01 update schematics
2024-10-16 ifdef RP2040-Zero
    fix for raspberry pi pico
    [DDS_PWM.ino, pwm.ino]
2026-10-14 trial 2Msps
    overclock ADC
2026-10-14 Revise ADC specifications and development environment
    Updated specifications and development environment details in README.
2026-10-14 Revise ADC overclocking details in README
    Updated ADC overclocking information for accuracy.
2026-10-15 fix DMA channel leak
